DerRKDCB/AS5600MultiTurn/img/README.md

# Knob gallery

Photos and CAD views of the [AS5600 multi-turn knob](../README.md). The [CAD and assembly guide](../cad/README.md) has the printable files and hardware notes.

## Printed parts and components

| Printed knob | Printed body and knob |
|:--:|:--:|
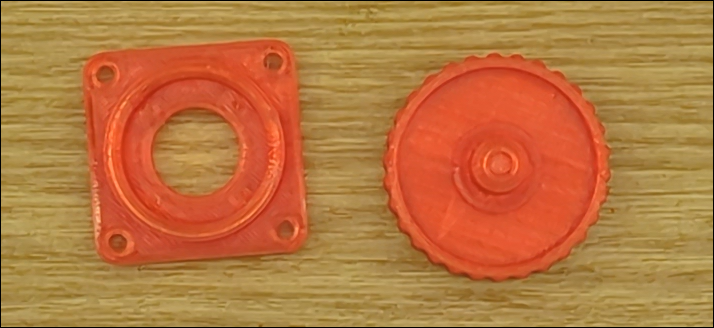
[picture p3: img/Screenshot_14-Oct_00-22-29_4728.png]
Undersides of the printed mounting body and knob
| Orange printed knob on a workbench |  |

| AS5600 breakout and pin header | 6000-series bearing | Small metal components |
|:--:|:--:|:--:|
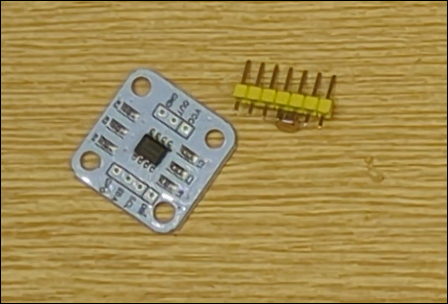
[picture p4: img/Screenshot_14-Oct_00-22-05_15401.png]
AS5600 breakout board with pin header
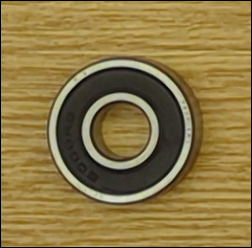
[picture p5: img/Screenshot_14-Oct_00-22-18_2878.png]
Bearing for the knob assembly
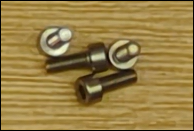
[picture p6: img/Screenshot_14-Oct_00-22-25_21472.png]
Small metal parts beside the printed components
|  |  |  |

## CAD assembly

| Side view | Transparent assembly |
|:--:|:--:|
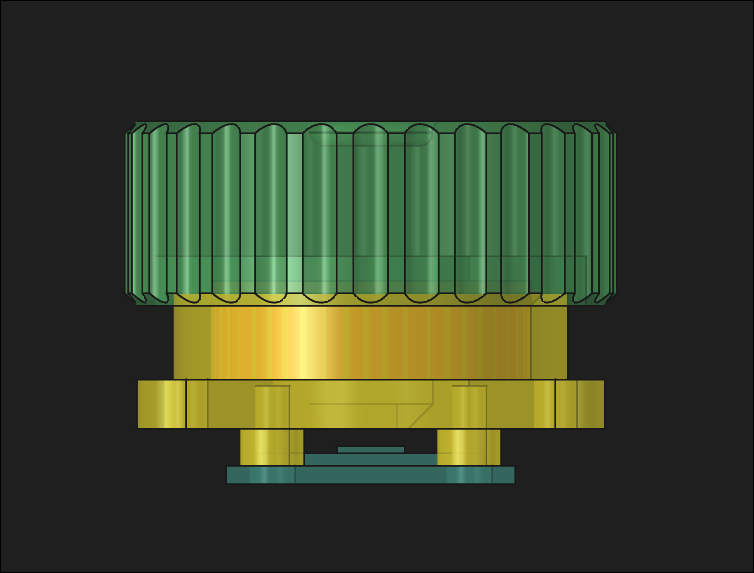
[picture p7: img/Screenshot_14-Oct_00-15-46_10970.png]
Side view of knob, mounting body and sensor board
|  | Transparent view showing the inside of the knob and bearing mount |

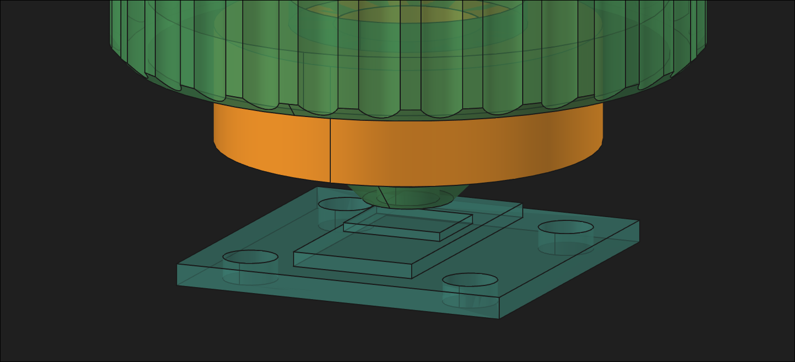
[picture p8: img/Screenshot_14-Oct_00-17-16_24835.png]
Close-up CAD view of the rotating knob over the AS5600 sensor board


## Video

[Watch the knob demonstration (MP4, 75 MB)](PXL_20261011_123336051.TS.mp4).
