DerRKDCB/AS5600MultiTurn/cad/3mf/multiturn_potentiometer_as5600-Body.3mf

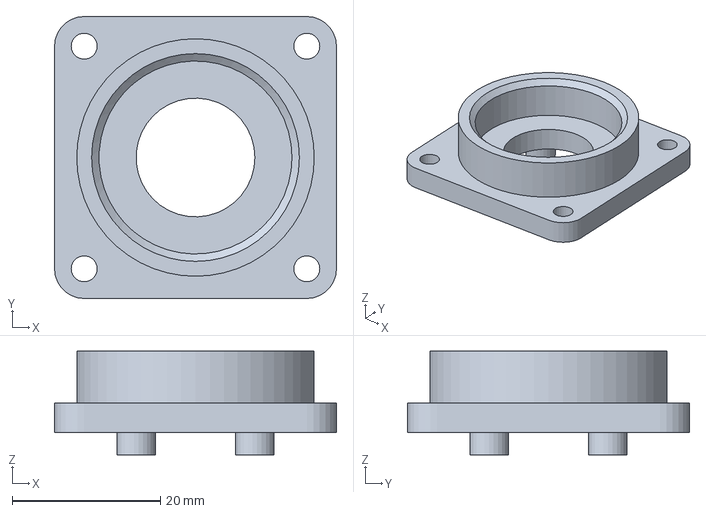
[picture p9: CAD file, 2026-10-13]
cad/3mf/multiturn_potentiometer_as5600-Body.3mf
38.0 x 38.0 x 14.0 mm
