DerRKDCB/AS5600MultiTurn/cad/multiturn_potentiometer_as5600.FCStd

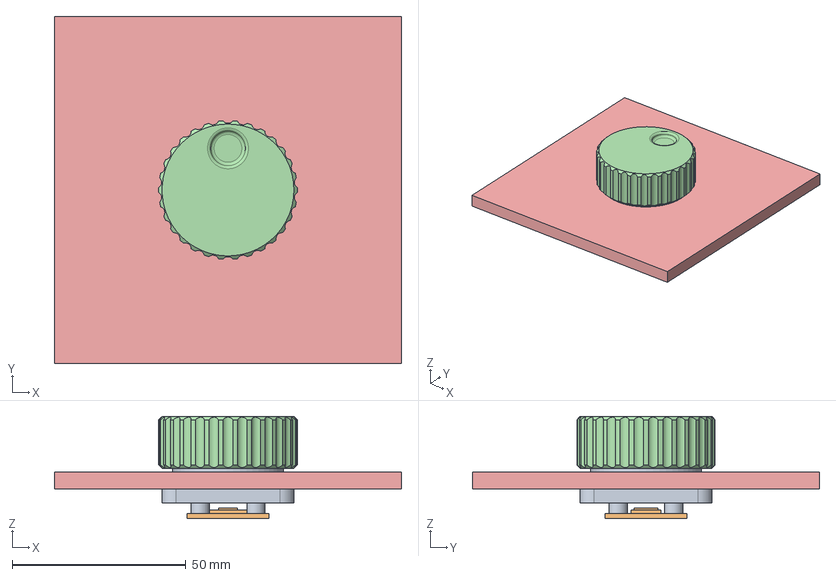
[picture p10: CAD file, 2026-10-13]
cad/multiturn_potentiometer_as5600.FCStd
100.0 x 100.0 x 29.5 mm
pcb
ball_bearing
knob
mounting_example
