DerRKDCB/AS5600MultiTurn/cad/3mf/multiturn_potentiometer_as5600-4x.3mf

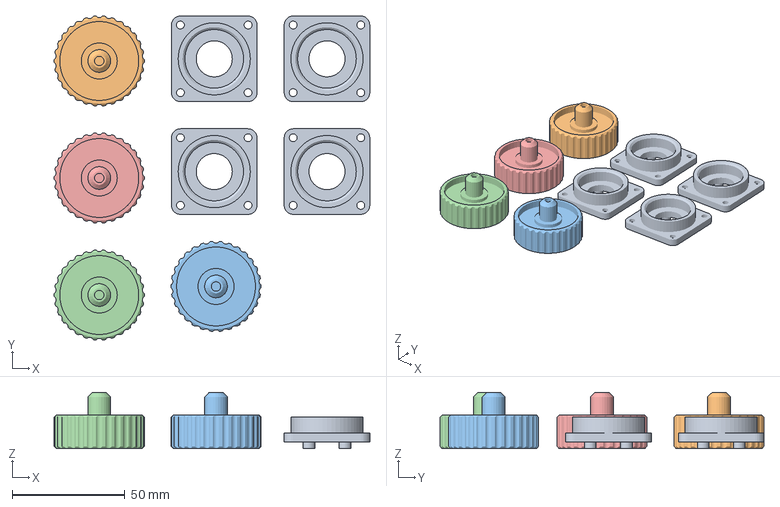
[picture p11: CAD file, 2026-10-13]
cad/3mf/multiturn_potentiometer_as5600-4x.3mf
140.0 x 143.7 x 25.0 mm
