DerRKDCB/AS5600MultiTurn/cad/3mf/multiturn_potentiometer_as5600-knob.3mf

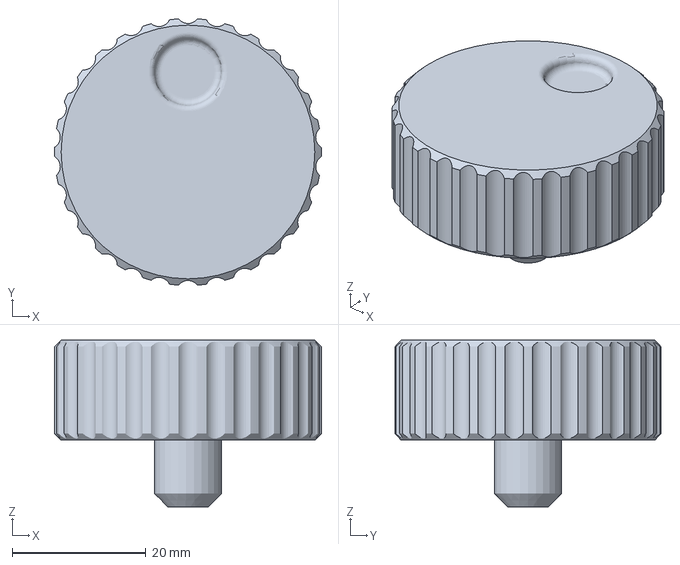
[picture p12: CAD file, 2026-10-13]
cad/3mf/multiturn_potentiometer_as5600-knob.3mf
40.0 x 39.9 x 25.0 mm
