DerRKDCB/AS5600MultiTurn/(commit log)

2026-10-10 All examples and main build verified on ESP32-C3
2026-10-10 Add encoder configuration: turns, output range, wrap/clamp, start position
2026-10-12 fix: pass custom TwoWire to Adafruit_AS5600::begin() and use platform default I2C pins
    - Fix bug where custom TwoWire reference was ignored when calling _as5600.begin()
    - Change default SDA/SCL pins from hardcoded 8/9 to platform-specific SDA/SCL macros
2026-10-13 Add knob CAD, media, and hardware documentation
    [multiturn_potentiometer_as5600-4x.3mf, multiturn_potentiometer_as5600-Body.3mf, multiturn_potentiometer_as5600-knob.3mf, multiturn_potentiometer_as5600.FCStd]
